TanoRoboRCJ/Hardware/README.md

# Hardware

アートボード 1

ロボットのハードウェアについてのリポジトリです。主に基板を扱います。
