TanoRoboRCJ/Hardware/PCB/01-main/main-re.dxf

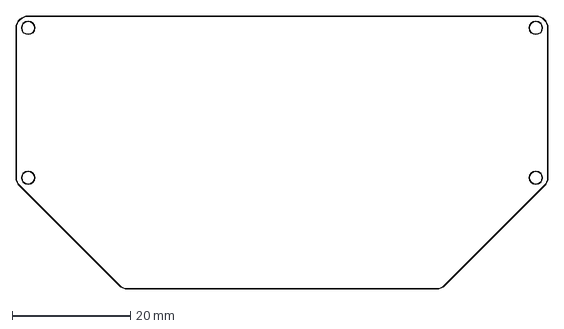
[picture p1: CAD file, 2024-01-18]
PCB/01-main/main-re.dxf
90.0 x 46.2 mm
