TanoRoboRCJ/Hardware/PCB/02-PWR/pwr-re.dxf

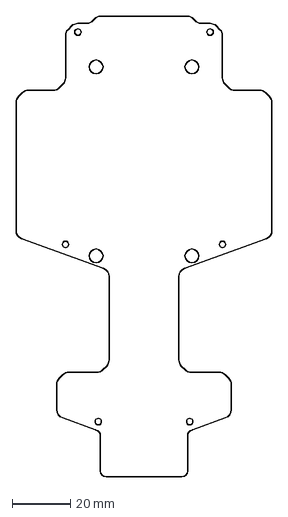
[picture p2: CAD file, 2024-01-20]
PCB/02-PWR/pwr-re.dxf
88.0 x 158.5 mm
