TanoRoboRCJ/Hardware/PCB/01-main.pdf

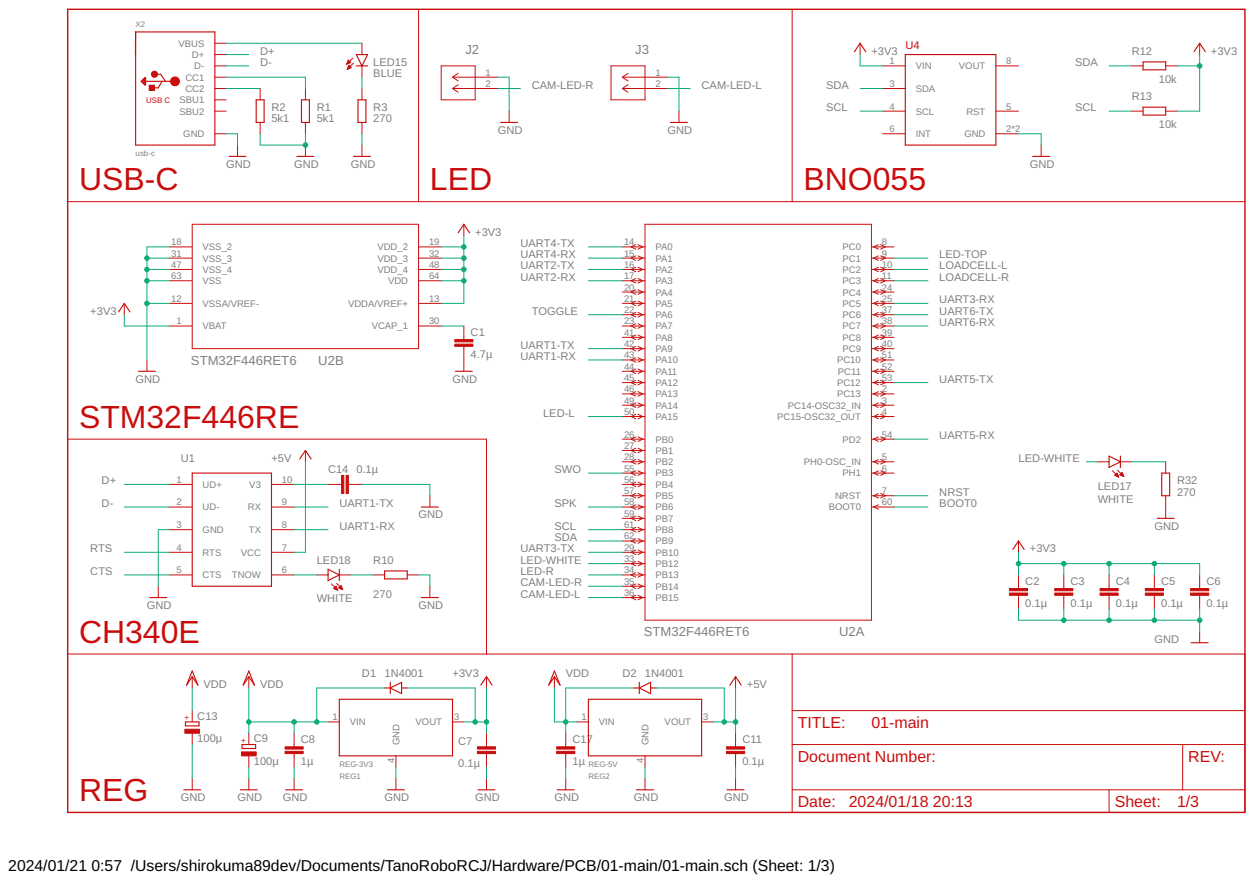
[picture p3: page 1]

2024/01/21 0:57 /Users/shirokuma89dev/Documents/TanoRoboRCJ/Hardware/PCB/01-main/01-main.sch (Sheet: 1/3)

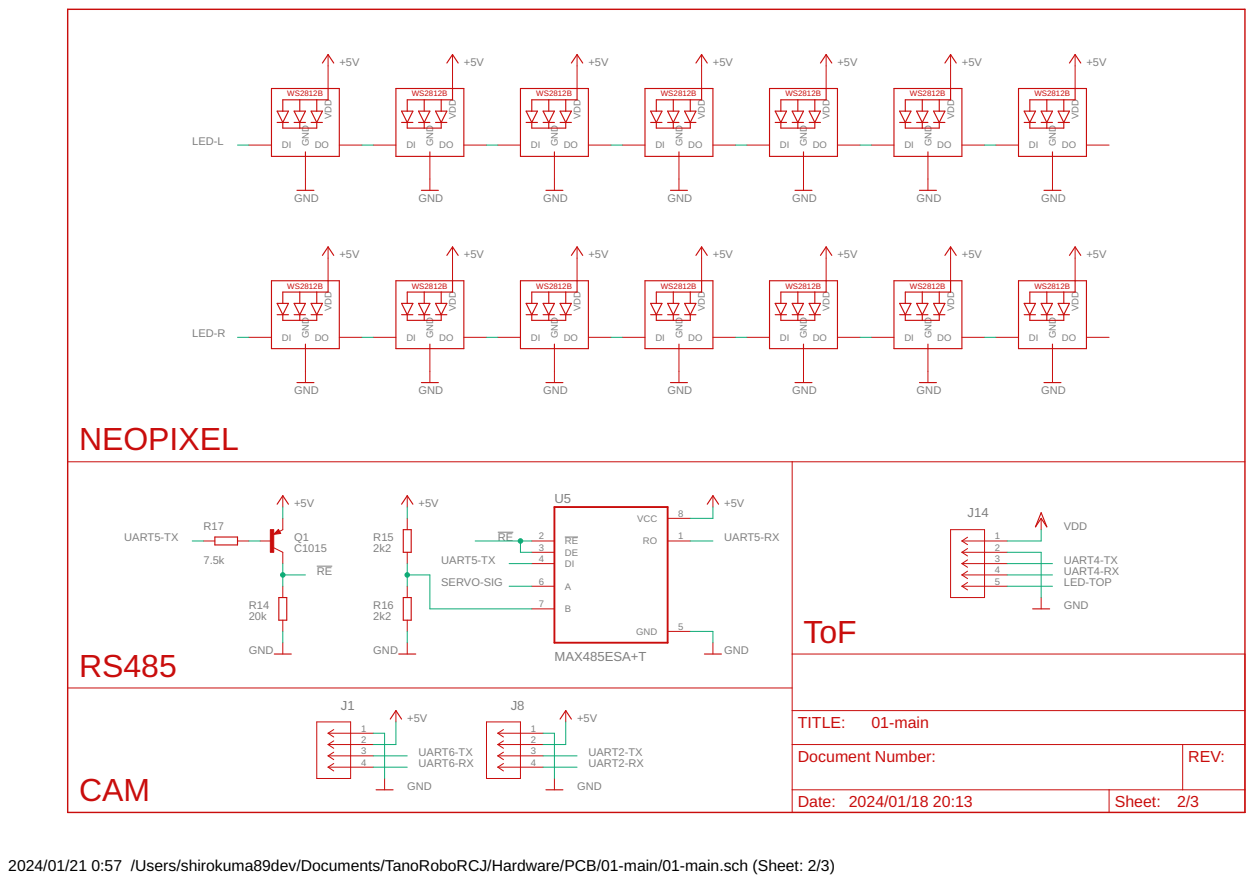
[picture p4: page 2]

2024/01/21 0:57 /Users/shirokuma89dev/Documents/TanoRoboRCJ/Hardware/PCB/01-main/01-main.sch (Sheet: 2/3)

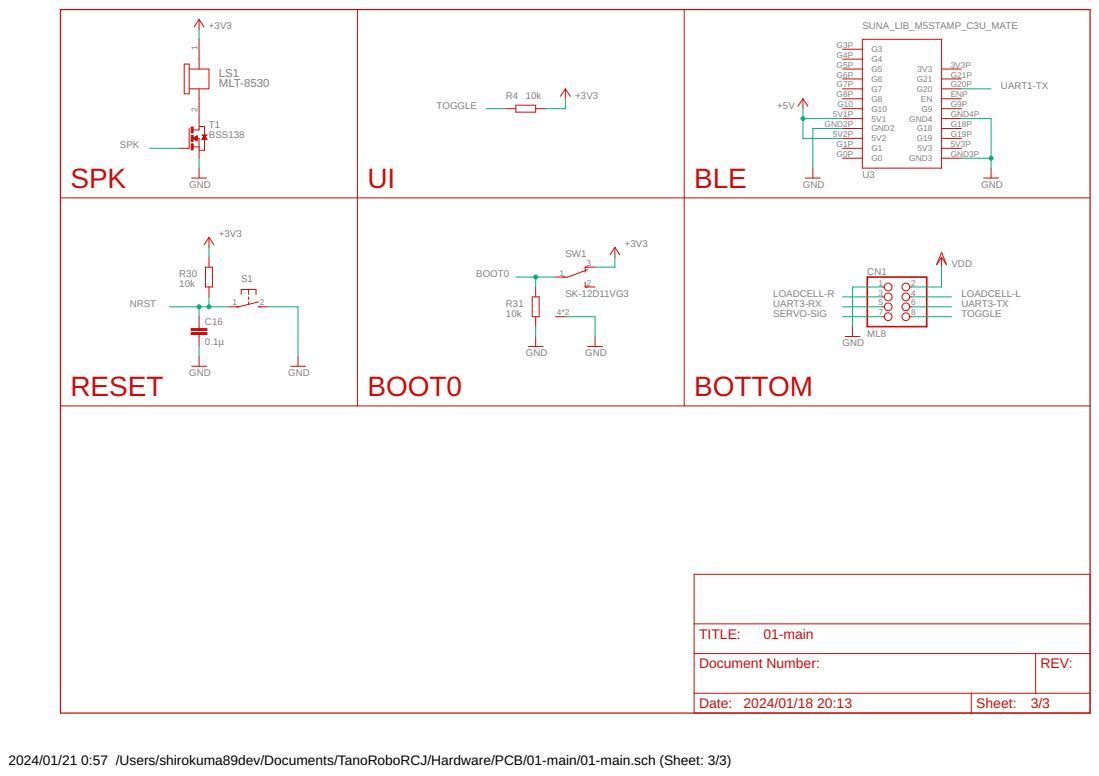
[picture p5: page 3]

Document Number: | REV:

Date: 2024/01/18 20:13 | Sheet: 3/3

2024/01/21 0:57 /Users/shirokuma89dev/Documents/TanoRoboRCJ/Hardware/PCB/01-main/01-main.sch (Sheet: 3/3)
