TanoRoboRCJ/Hardware/PCB/02-PWR/02-PWR.brd

## EAGLE design PCB/02-PWR/02-PWR.brd (2024-01-26)

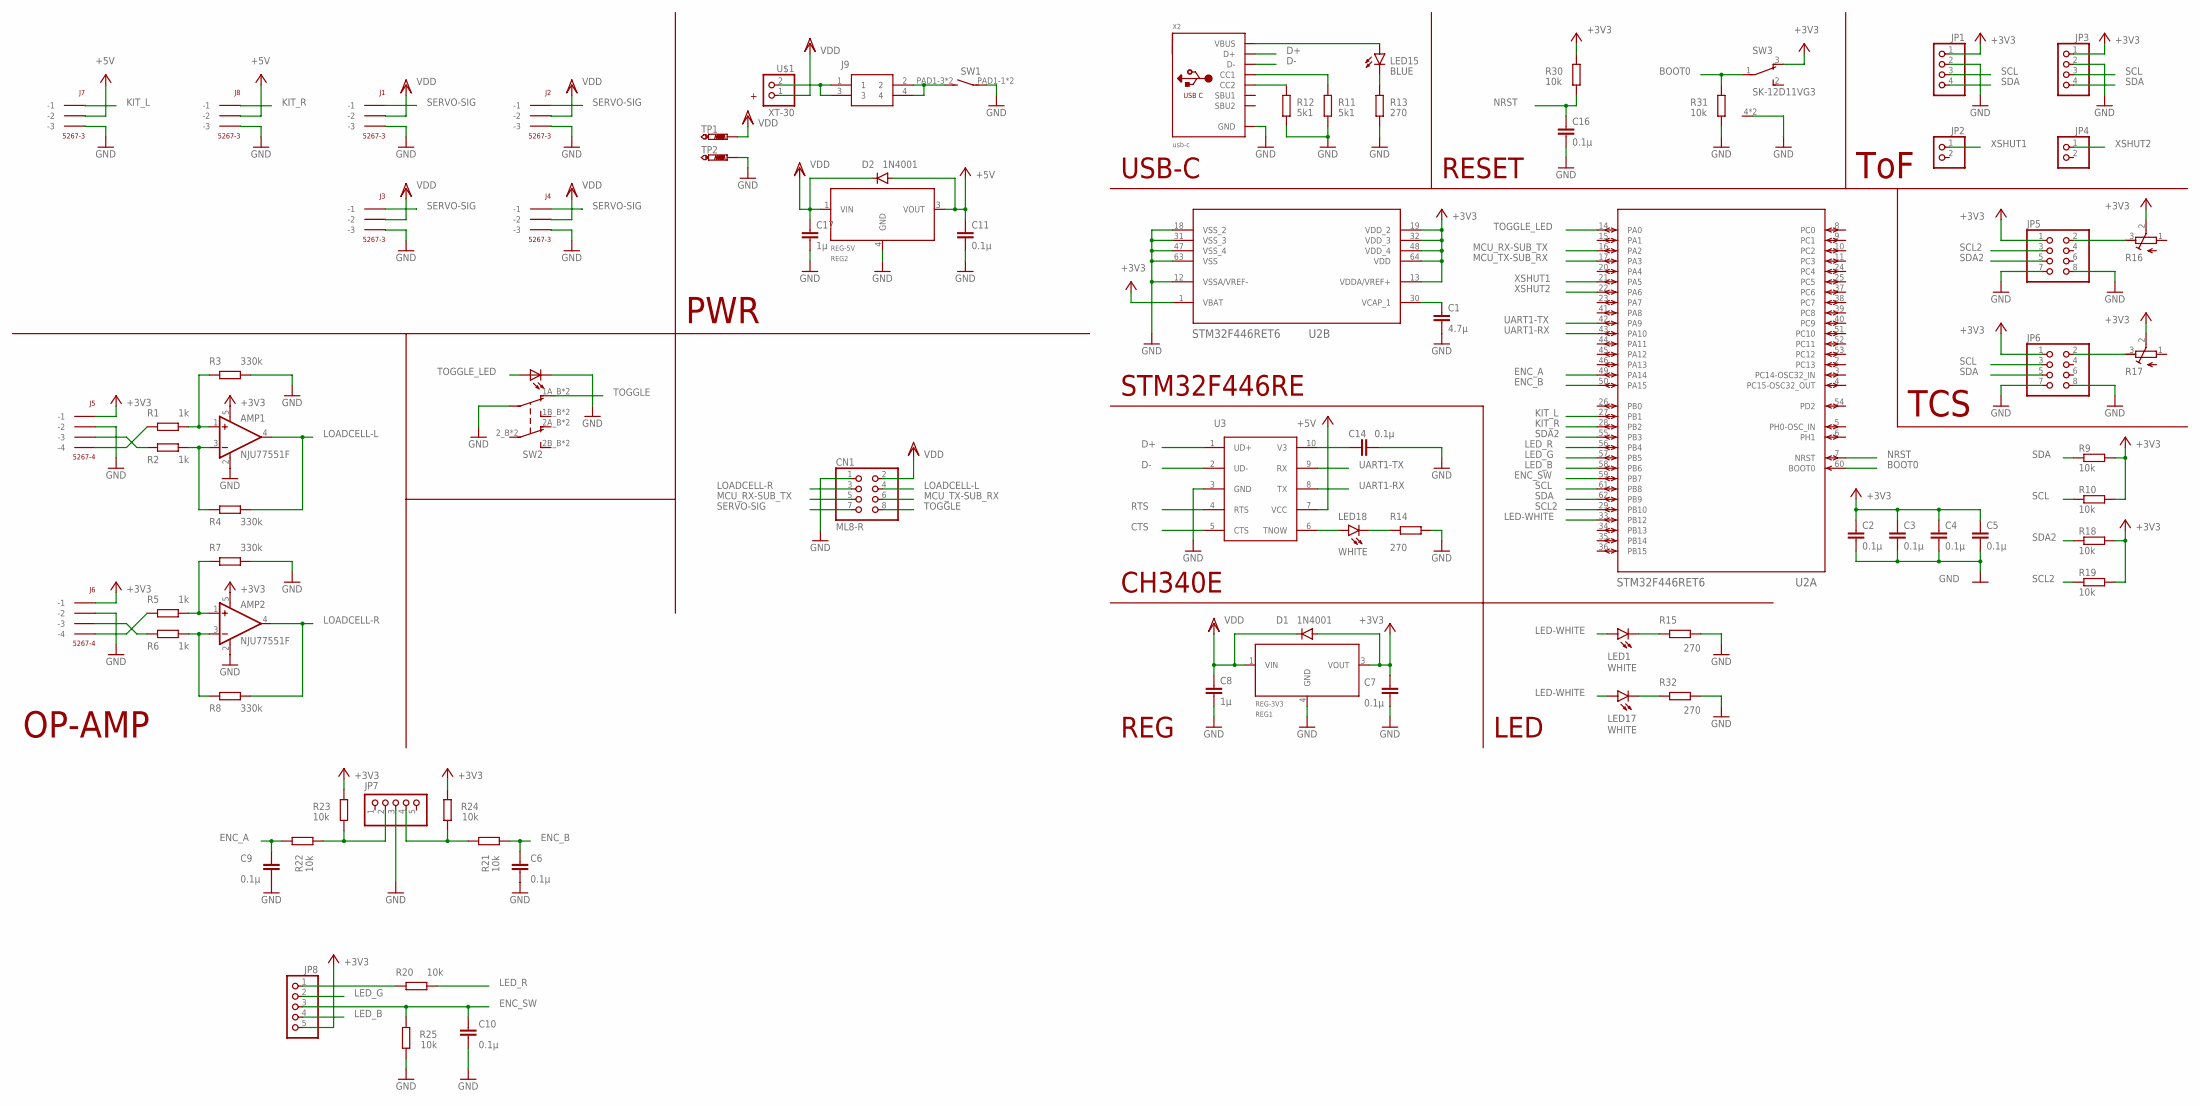
[picture p6: schematic 02-PWR.sch]

Parts:
AMP1, AMP2: NJU77551F; SOT23-5
C1: 4.7µ; C0603
C2, C3, C4, C5, C6, C7, C9, C10, C11, C14, C16: 0.1µ; C0603
C8, C17: 1µ; C0603
CN1: ML8-R; ML6
D1, D2: 1N4001; SMA-DO214AC
J1, J2, J3, J4, J7, J8: 5267-3
J5, J6: 5267-4
J9: 3557-2
JP1, JP3: PINHD-1X4; 1X04
JP2, JP4: PINHD-1X2; 1X02
JP5, JP6: PINHD-2X4; 2X04
JP7, JP8: PINHD-1X5; 1X05
LED1, LED17, LED18: WHITE; SML0603
LED15: BLUE; SML0603
R1, R2, R5, R6: 1k; R0805
R3, R4, R7, R8: 330k; R0805
R9, R10, R18, R19, R20, R21, R22, R23, R24, R25, R30, R31: 10k; R0402
R11, R12: 5k1; R0402
R13, R14, R15, R32: 270; R0402
R16, R17: R-TRIMM3339P; RTRIM3339P
REG1: REG-3V3; MYPARTS_D-PAK_TO252AA
REG2: REG-5V; MYPARTS_D-PAK_TO252AA
SW1: MYPARTS2_C01B02BKBK-EI
SW2: TL22
SW3: SK-12D11VG3
TP1, TP2: PTR1TP16R; TP16R
U2: STM32F446RET6; LQFP64-10X10MM
U3: CH340ESMD; MSOP10
U$1: XT-30
X2: usb-c; USB_C_CUSB31-CFM2AX-01-X

Connections:
+3V3: AMP1.5 (V+), AMP2.5 (V+), C2.1, C3.1, C4.1, C5.1, C7.1, D1.A, J5.P$1 (-1), J6.P$1 (-1), JP1.1, JP3.1, JP5.1, JP6.1, JP8.5, R9.2, R10.2, R16.2 (S), R17.2 (S), R18.2, R19.2, R23.1, R24.1, R30.1, REG1.3 (VOUT), SW3.3 (O), U2.1 (VBAT), U2.13 (VDDA/VREF+), U2.19 (VDD_2), U2.32 (VDD_3), U2.48 (VDD_4), U2.64 (VDD)
+5V: C11.1, D2.A, J7.P$2 (-2), J8.P$2 (-2), REG2.3 (VOUT), U3.7 (VCC)
BOOT0: R31.1, SW3.1, U2.60 (BOOT0)
CTS: U3.5 (CTS)
D+: U3.1 (UD+), X2.A6 (D+), X2.B6 (D+)
D-: U3.2 (UD-), X2.A7 (D-), X2.B7 (D-)
ENC_A: C9.1, R22.1, U2.49 (PA14)
ENC_B: C6.1, R21.2, U2.50 (PA15)
ENC_SW: C10.1, JP8.3, R25.1, U2.59 (PB7)
GND: AMP1.2 (V-), AMP2.2 (V-), C1.2, C2.2, C3.2, C4.2, C5.2, C6.2, C7.2, C8.2, C9.2, C10.2, C11.2, C14.2, C16.2, C17.2, CN1.1, J1.P$3 (-3), J2.P$3 (-3), J3.P$3 (-3), J4.P$3 (-3), J5.P$2 (-2), J6.P$2 (-2), J7.P$3 (-3), J8.P$3 (-3), JP1.2, JP3.2, JP5.7, JP5.8, JP6.7, JP6.8, JP7.3, R3.2, R7.2, R11.2, R12.2, R13.1, R14.1, R15.1, R25.2, R31.2, R32.1, REG1.4 (GND), REG2.4 (GND), SW1.PAD1-1, SW1.PAD1-2, SW2.1_B (1), SW2.1_T (1), SW2.L-_B (C), SW2.L-_T (C), SW3.4 (CASE), SW3.5 (CASE), TP2.TP, U2.12 (VSSA/VREF-), U2.18 (VSS_2), U2.31 (VSS_3), U2.47 (VSS_4), U2.63 (VSS), U3.3 (GND), X2.A1B12 (GND), X2.B1A12 (GND)
KIT_L: J7.P$1 (-1), U2.27 (PB1)
KIT_R: J8.P$1 (-1), U2.28 (PB2)
LED-WHITE: LED1.A, LED17.A, U2.33 (PB12)
LED_B: JP8.4, U2.58 (PB6)
LED_G: JP8.2, U2.57 (PB5)
LED_R: R20.2, U2.56 (PB4)
LOADCELL-L: AMP1.4 (OUT), CN1.4, R4.2
LOADCELL-R: AMP2.4 (OUT), CN1.3, R8.2
MCU_RX-SUB_TX: CN1.5, U2.16 (PA2)
MCU_TX-SUB_RX: CN1.6, U2.17 (PA3)
unnamed: J5.P$3 (-3), R2.1
unnamed: J5.P$4 (-4), R1.1
unnamed: AMP1.3 (-IN), R2.2, R4.1
unnamed: AMP1.1 (+IN), R1.2, R3.1
unnamed: J6.P$3 (-3), R6.1
unnamed: J6.P$4 (-4), R5.1
unnamed: AMP2.3 (-IN), R6.2, R8.1
unnamed: AMP2.1 (+IN), R5.2, R7.1
unnamed: J9.1, J9.3, U$1.2
unnamed: J9.2, J9.4, SW1.PAD1-3 (S), SW1.PAD1-4 (S)
unnamed: C14.1, U3.10 (V3)
unnamed: LED1.C, R15.2
unnamed: JP5.2, R16.3 (E)
unnamed: R11.1, X2.A5 (CC1)
unnamed: R12.1, X2.B5 (CC2)
unnamed: LED15.C, R13.2
unnamed: JP6.2, R17.3 (E)
unnamed: C1.1, U2.30 (VCAP_1)
unnamed: LED18.A, U3.6 (TNOW)
unnamed: LED18.C, R14.2
unnamed: JP7.4, R21.1, R24.2
unnamed: JP7.2, R22.2, R23.2
unnamed: JP8.1, R20.1
unnamed: LED17.C, R32.2
unnamed: LED15.A, X2.A4B9 (VBUS), X2.B4A9 (VBUS)
NRST: C16.1, R30.2, U2.7 (NRST)
RTS: U3.4 (RTS)
SCL: JP1.3, JP3.3, JP6.3, R10.1, U2.61 (PB8)
SCL2: JP5.3, R19.1, U2.29 (PB10)
SDA: JP1.4, JP3.4, JP6.5, R9.1, U2.62 (PB9)
SDA2: JP5.5, R18.1, U2.55 (PB3)
SERVO-SIG: CN1.7, J1.P$1 (-1), J2.P$1 (-1), J3.P$1 (-1), J4.P$1 (-1)
TOGGLE: CN1.8, SW2.1A_B (1A), SW2.1A_T (1A)
TOGGLE_LED: SW2.L+_B (A), SW2.L+_T (A), U2.14 (PA0)
UART1-RX: U2.43 (PA10), U3.8 (TX)
UART1-TX: U2.42 (PA9), U3.9 (RX)
VDD: C8.1, C17.1, CN1.2, D1.K (C), D2.K (C), J1.P$2 (-2), J2.P$2 (-2), J3.P$2 (-2), J4.P$2 (-2), REG1.1 (VIN), REG2.1 (VIN), TP1.TP, U$1.1
XSHUT1: JP2.1, U2.21 (PA5)
XSHUT2: JP4.1, U2.22 (PA6)

Notes on the sheet:
PWR
ToF
OP-AMP
STM32F446RE
REG
CH340E
USB-C
RESET
LED
TCS

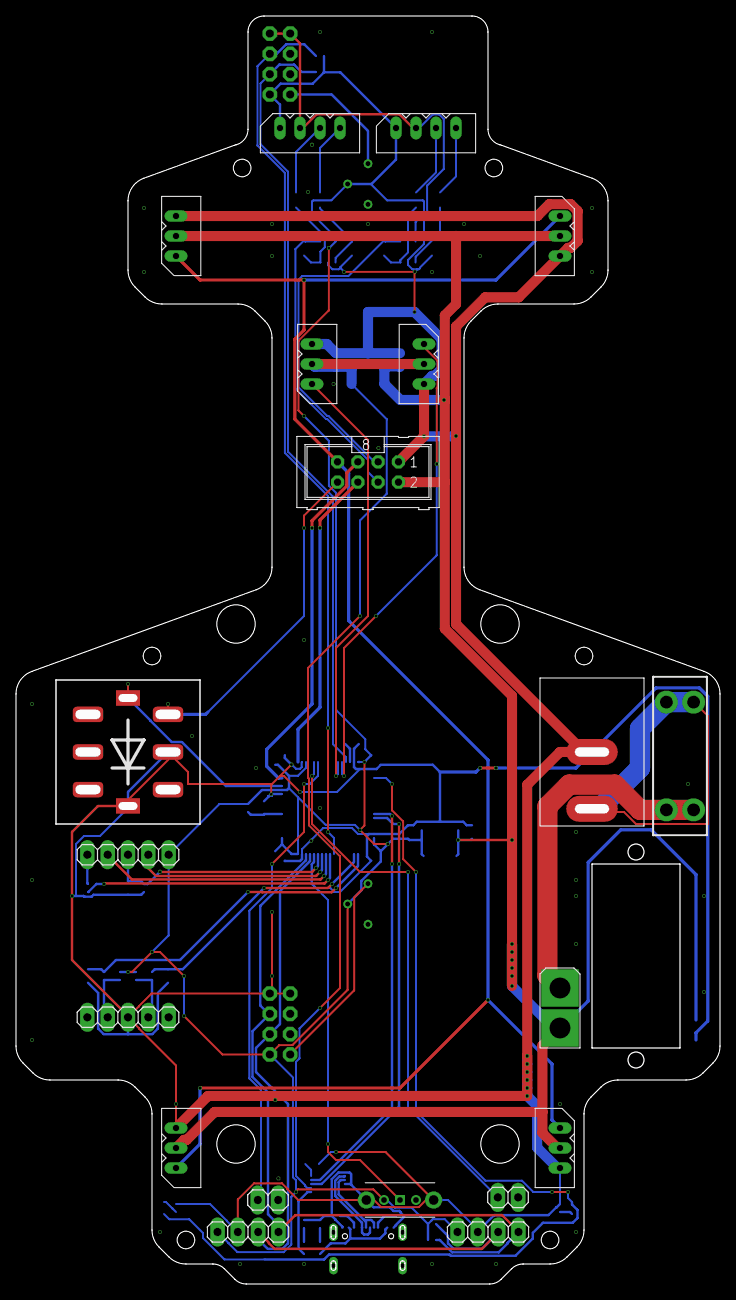
[picture p7: board 02-PWR.brd from above]

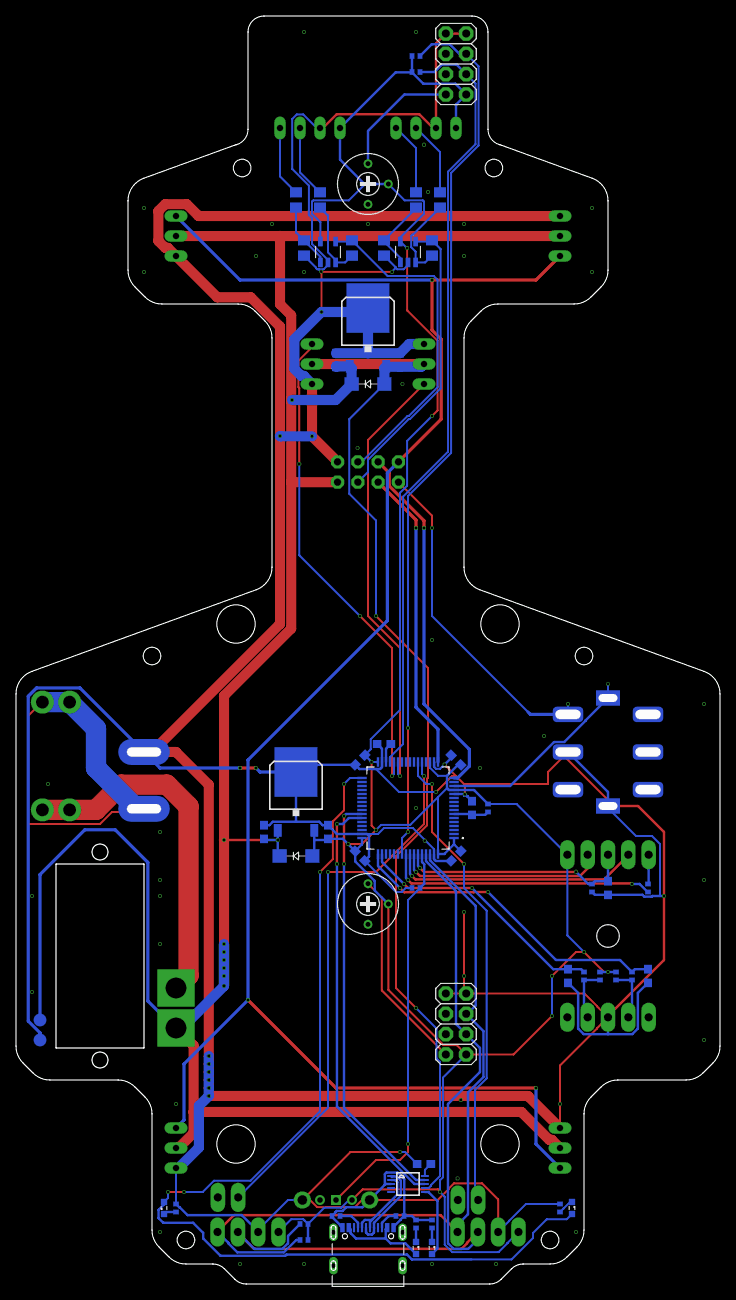
[picture p8: board 02-PWR.brd from below]

Board: 2 copper layers, 88.0 x 158.5 mm, 79 parts (59 on the bottom side), 57 nets.
