TanoRoboRCJ/Hardware/PCB/03-LiDAR/03-LiDAR.brd

## EAGLE design PCB/03-LiDAR/03-LiDAR.brd (2024-01-25)

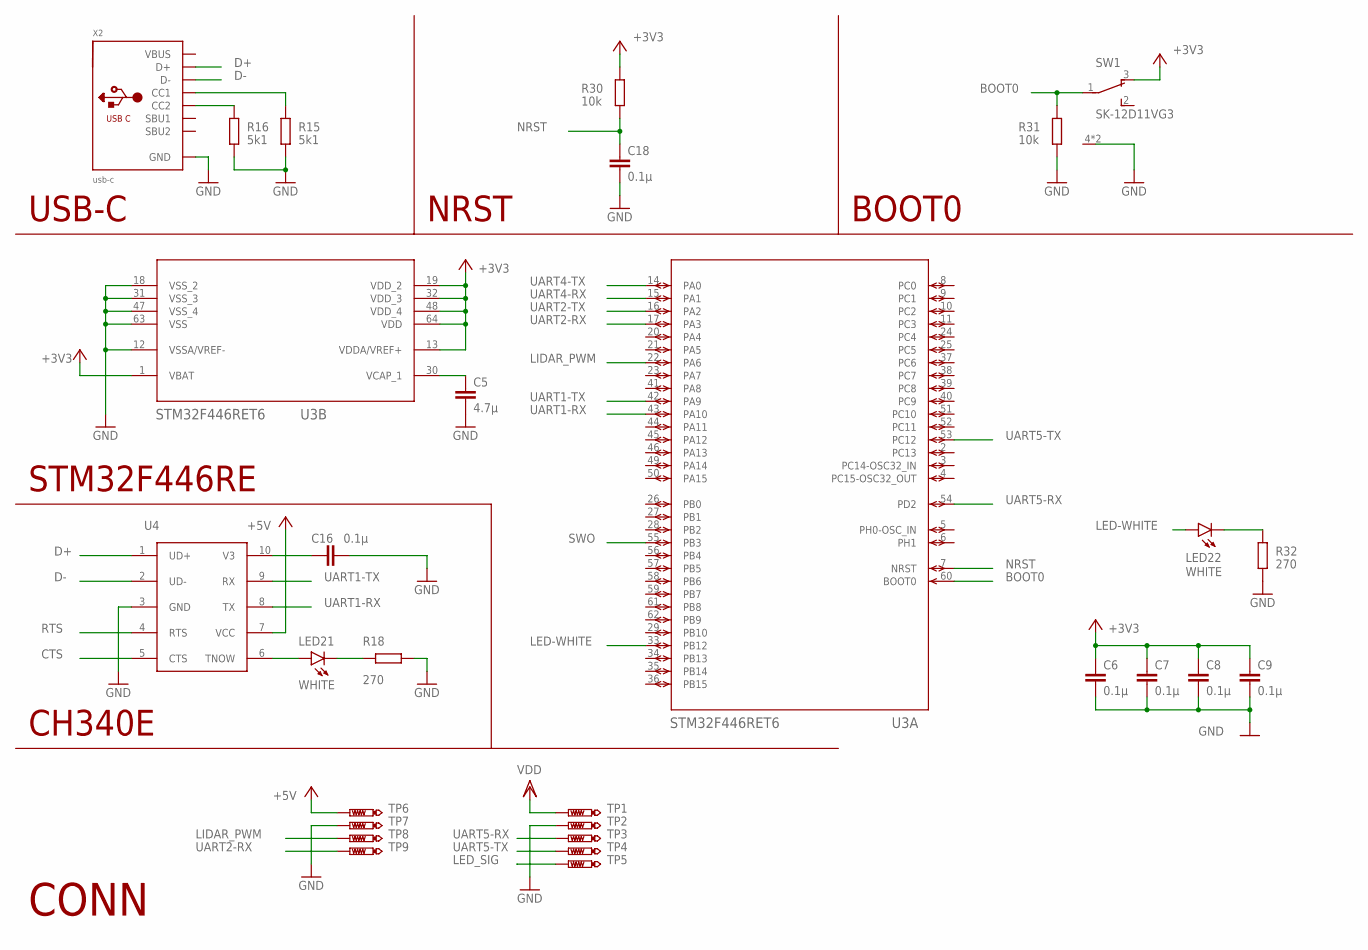
[picture p9: schematic 03-LiDAR.sch, sheet 1]

Parts:
C5: 4.7µ; C0603
C6, C7, C8, C9, C16, C18: 0.1µ; C0603
LED21, LED22: WHITE; SML0603
R15, R16: 5k1; R0402
R18, R32: 270; R0402
R30, R31: 10k; R0402
SW1: SK-12D11VG3
TP1, TP3, TP4, TP5, TP6, TP8, TP9: PTR1TP10R; TP10R
TP2, TP7: PTR1TP10SQ; TP10SQ
U3: STM32F446RET6; LQFP64-10X10MM
U4: CH340ESMD; MSOP10
X2: usb-c; USB_C_CUSB31-CFM2AX-01-X

Connections:
+3V3: C6.1, C7.1, C8.1, C9.1, R30.1, SW1.3 (O), U3.1 (VBAT), U3.13 (VDDA/VREF+), U3.19 (VDD_2), U3.32 (VDD_3), U3.48 (VDD_4), U3.64 (VDD); also elsewhere on the board
+5V: TP6.TP, U4.7 (VCC); also elsewhere on the board
BOOT0: R31.1, SW1.1, U3.60 (BOOT0)
CTS: U4.5 (CTS)
D+: U4.1 (UD+), X2.A6 (D+), X2.B6 (D+)
D-: U4.2 (UD-), X2.A7 (D-), X2.B7 (D-)
GND: C5.2, C6.2, C7.2, C8.2, C9.2, C16.2, C18.2, R15.2, R16.2, R18.1, R31.2, R32.1, SW1.4 (CASE), SW1.5 (CASE), TP2.TP, TP7.TP, U3.12 (VSSA/VREF-), U3.18 (VSS_2), U3.31 (VSS_3), U3.47 (VSS_4), U3.63 (VSS), U4.3 (GND), X2.A1B12 (GND), X2.B1A12 (GND); also elsewhere on the board
LED-WHITE: LED22.A, U3.33 (PB12)
LED_SIG: TP5.TP; also elsewhere on the board
LIDAR_PWM: TP8.TP, U3.22 (PA6)
unnamed: R15.1, X2.A5 (CC1)
unnamed: R16.1, X2.B5 (CC2)
unnamed: C5.1, U3.30 (VCAP_1)
unnamed: C16.1, U4.10 (V3)
unnamed: LED21.A, U4.6 (TNOW)
unnamed: LED21.C, R18.2
unnamed: LED22.C, R32.2
NRST: C18.1, R30.2, U3.7 (NRST)
RTS: U4.4 (RTS)
SWO: U3.55 (PB3)
UART1-RX: U3.43 (PA10), U4.8 (TX)
UART1-TX: U3.42 (PA9), U4.9 (RX)
UART2-RX: TP9.TP, U3.17 (PA3)
UART2-TX: U3.16 (PA2)
UART4-RX: U3.15 (PA1); also elsewhere on the board
UART4-TX: U3.14 (PA0)
UART5-RX: TP3.TP, U3.54 (PD2); also elsewhere on the board
UART5-TX: TP4.TP, U3.53 (PC12)
VBUS: X2.A4B9 (VBUS), X2.B4A9 (VBUS)
VDD: TP1.TP; also elsewhere on the board

Notes on the sheet:
CONN
STM32F446RE
CH340E
USB-C
BOOT0
NRST

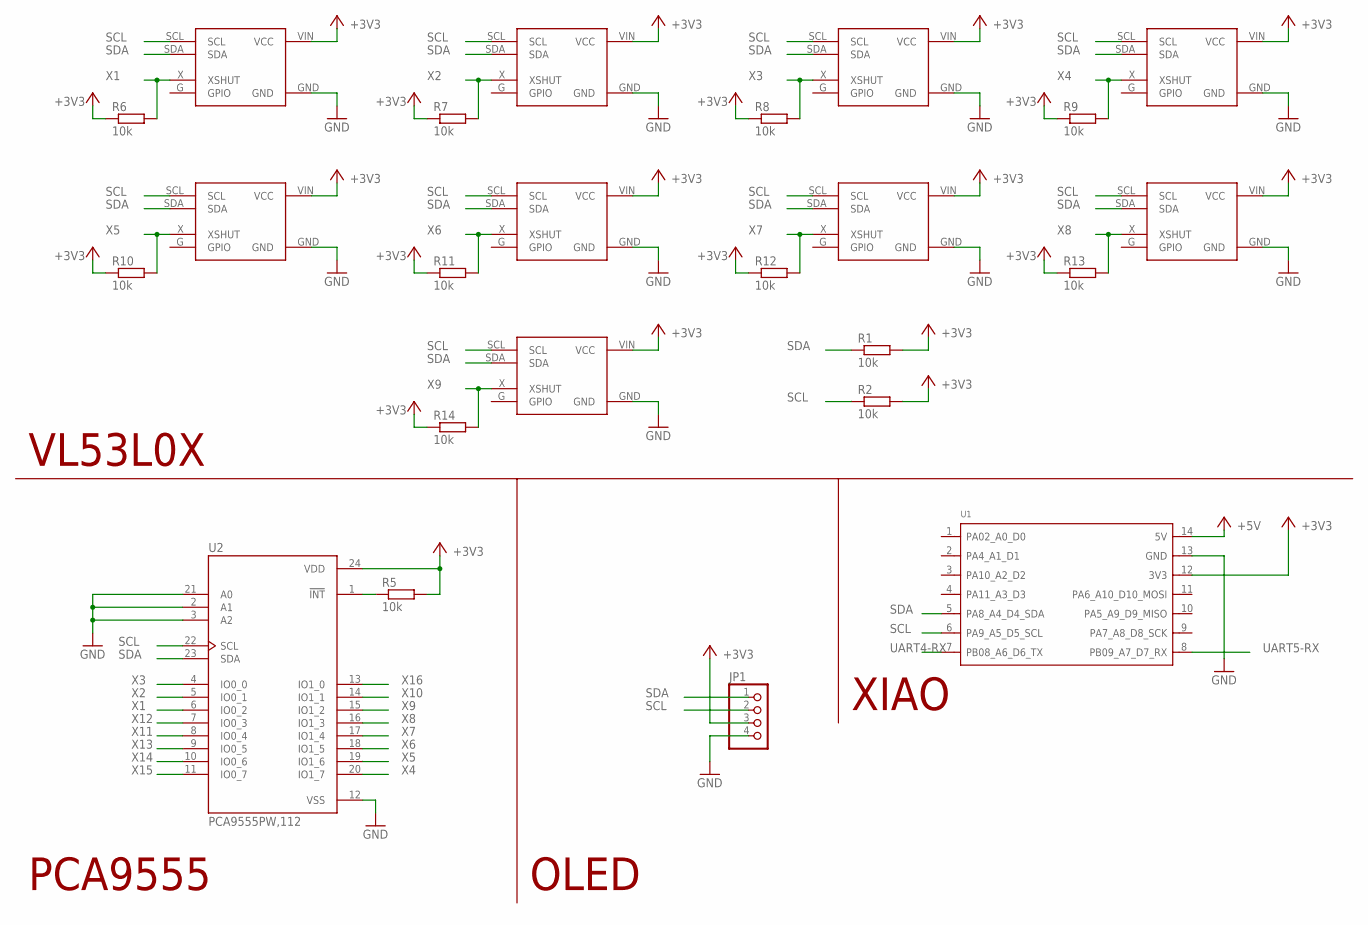
[picture p10: schematic 03-LiDAR.sch, sheet 2]

Parts:
JP1: PINHD-1X4; 1X04
R1, R2, R5, R6, R7, R8, R9, R10, R11, R12, R13, R14: 10k; R0402
U1: MOUDLE-SEEEDUINO-XIAO; MOUDLE14P-2.54-21X17.8MM
U2: PCA9555PW,112; SOP65P640X110-24N
VL1, VL2, VL3, VL4, VL5, VL6, VL7, VL8, VL9: VL53L0X; 1X04

Connections:
+3V3: JP1.3, R1.2, R2.2, R5.2, R6.1, R7.1, R8.1, R9.1, R10.1, R11.1, R12.1, R13.1, R14.1, U1.12 (3V3), U2.24 (VDD), VL1.VIN (VCC), VL2.VIN (VCC), VL3.VIN (VCC), VL4.VIN (VCC), VL5.VIN (VCC), VL6.VIN (VCC), VL7.VIN (VCC), VL8.VIN (VCC), VL9.VIN (VCC); also elsewhere on the board
+5V: U1.14 (5V); also elsewhere on the board
GND: JP1.4, U1.13 (GND), U2.2 (A1), U2.3 (A2), U2.12 (VSS), U2.21 (A0), VL1.GND, VL2.GND, VL3.GND, VL4.GND, VL5.GND, VL6.GND, VL7.GND, VL8.GND, VL9.GND; also elsewhere on the board
unnamed: R5.1, U2.1 (!INT)
SCL: JP1.2, R2.1, U1.6 (PA9_A5_D5_SCL), U2.22 (SCL), VL1.SCL, VL2.SCL, VL3.SCL, VL4.SCL, VL5.SCL, VL6.SCL, VL7.SCL, VL8.SCL, VL9.SCL
SDA: JP1.1, R1.1, U1.5 (PA8_A4_D4_SDA), U2.23 (SDA), VL1.SDA, VL2.SDA, VL3.SDA, VL4.SDA, VL5.SDA, VL6.SDA, VL7.SDA, VL8.SDA, VL9.SDA
UART4-RX: U1.7 (PB08_A6_D6_TX); also elsewhere on the board
UART5-RX: U1.8 (PB09_A7_D7_RX); also elsewhere on the board
X1: R6.2, U2.6 (IO0_2), VL1.X (XSHUT)
X2: R7.2, U2.5 (IO0_1), VL2.X (XSHUT)
X3: R8.2, U2.4 (IO0_0), VL3.X (XSHUT)
X4: R9.2, U2.20 (IO1_7), VL4.X (XSHUT)
X5: R10.2, U2.19 (IO1_6), VL5.X (XSHUT)
X6: R11.2, U2.18 (IO1_5), VL6.X (XSHUT)
X7: R12.2, U2.17 (IO1_4), VL7.X (XSHUT)
X8: R13.2, U2.16 (IO1_3), VL8.X (XSHUT)
X9: R14.2, U2.15 (IO1_2), VL9.X (XSHUT)
X10: U2.14 (IO1_1)
X11: U2.8 (IO0_4)
X12: U2.7 (IO0_3)
X13: U2.9 (IO0_5)
X14: U2.10 (IO0_6)
X15: U2.11 (IO0_7)
X16: U2.13 (IO1_0)

Notes on the sheet:
VL53L0X
XIAO
PCA9555
OLED

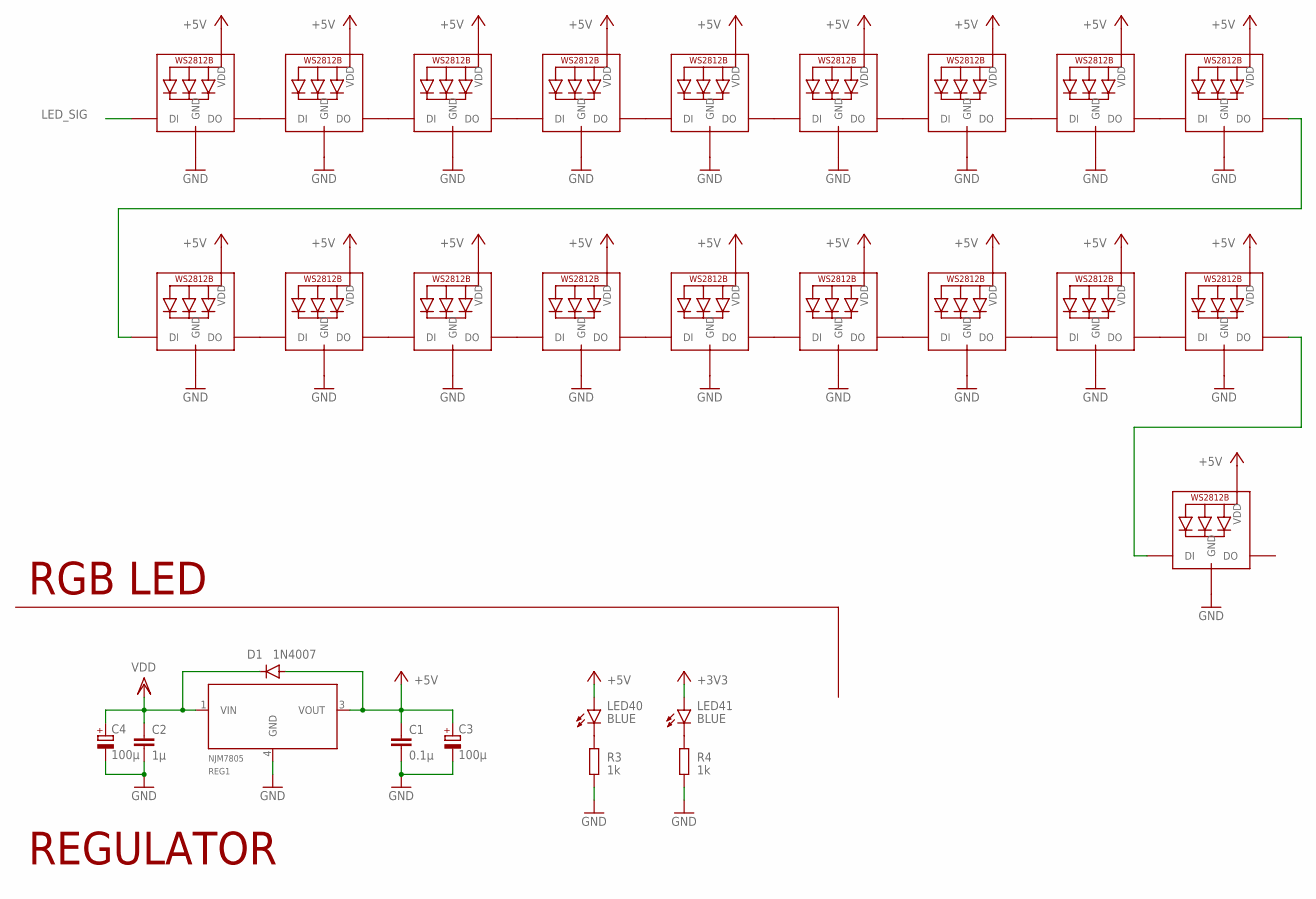
[picture p11: schematic 03-LiDAR.sch, sheet 3]

Parts:
C1: 0.1μ; C0402
C2: 1μ; C0402
C3, C4: 100μ; 153CLV-0505
D1: 1N4007; SMA-DO214AC
LED1, LED2, LED3, LED4, LED5, LED6, LED7, LED8, LED9, LED10, LED11, LED12, LED13, LED14, LED15, LED16, LED17, LED18, LED19: WS2812B_5050N; WS2812B-NARROW
LED40, LED41: BLUE; SML0603
R3, R4: 1k; R0402
REG1: NJM7805; MYPARTS_D-PAK_TO252AA

Connections:
+3V3: LED41.A; also elsewhere on the board
+5V: C1.1, C3.+, D1.A, LED1.1-VDD (VDD), LED2.1-VDD (VDD), LED3.1-VDD (VDD), LED4.1-VDD (VDD), LED5.1-VDD (VDD), LED6.1-VDD (VDD), LED7.1-VDD (VDD), LED8.1-VDD (VDD), LED9.1-VDD (VDD), LED10.1-VDD (VDD), LED11.1-VDD (VDD), LED12.1-VDD (VDD), LED13.1-VDD (VDD), LED14.1-VDD (VDD), LED15.1-VDD (VDD), LED16.1-VDD (VDD), LED17.1-VDD (VDD), LED18.1-VDD (VDD), LED19.1-VDD (VDD), LED40.A, REG1.3 (VOUT); also elsewhere on the board
GND: C1.2, C2.2, C3.-, C4.-, LED1.3-GND (GND), LED2.3-GND (GND), LED3.3-GND (GND), LED4.3-GND (GND), LED5.3-GND (GND), LED6.3-GND (GND), LED7.3-GND (GND), LED8.3-GND (GND), LED9.3-GND (GND), LED10.3-GND (GND), LED11.3-GND (GND), LED12.3-GND (GND), LED13.3-GND (GND), LED14.3-GND (GND), LED15.3-GND (GND), LED16.3-GND (GND), LED17.3-GND (GND), LED18.3-GND (GND), LED19.3-GND (GND), R3.2, R4.2, REG1.4 (GND); also elsewhere on the board
LED_SIG: LED1.4-DIN (DI); also elsewhere on the board
unnamed: LED1.2-DOUT (DO), LED2.4-DIN (DI)
unnamed: LED2.2-DOUT (DO), LED3.4-DIN (DI)
unnamed: LED3.2-DOUT (DO), LED4.4-DIN (DI)
unnamed: LED4.2-DOUT (DO), LED5.4-DIN (DI)
unnamed: LED5.2-DOUT (DO), LED6.4-DIN (DI)
unnamed: LED6.2-DOUT (DO), LED7.4-DIN (DI)
unnamed: LED7.2-DOUT (DO), LED8.4-DIN (DI)
unnamed: LED8.2-DOUT (DO), LED9.4-DIN (DI)
unnamed: LED10.2-DOUT (DO), LED11.4-DIN (DI)
unnamed: LED11.2-DOUT (DO), LED12.4-DIN (DI)
unnamed: LED12.2-DOUT (DO), LED13.4-DIN (DI)
unnamed: LED13.2-DOUT (DO), LED14.4-DIN (DI)
unnamed: LED14.2-DOUT (DO), LED15.4-DIN (DI)
unnamed: LED15.2-DOUT (DO), LED16.4-DIN (DI)
unnamed: LED16.2-DOUT (DO), LED17.4-DIN (DI)
unnamed: LED17.2-DOUT (DO), LED18.4-DIN (DI)
unnamed: LED40.C, R3.1
unnamed: LED41.C, R4.1
unnamed: LED9.2-DOUT (DO), LED10.4-DIN (DI)
unnamed: LED18.2-DOUT (DO), LED19.4-DIN (DI)
VDD: C2.1, C4.+, D1.K (C), REG1.1 (VIN); also elsewhere on the board

Notes on the sheet:
REGULATOR
RGB LED

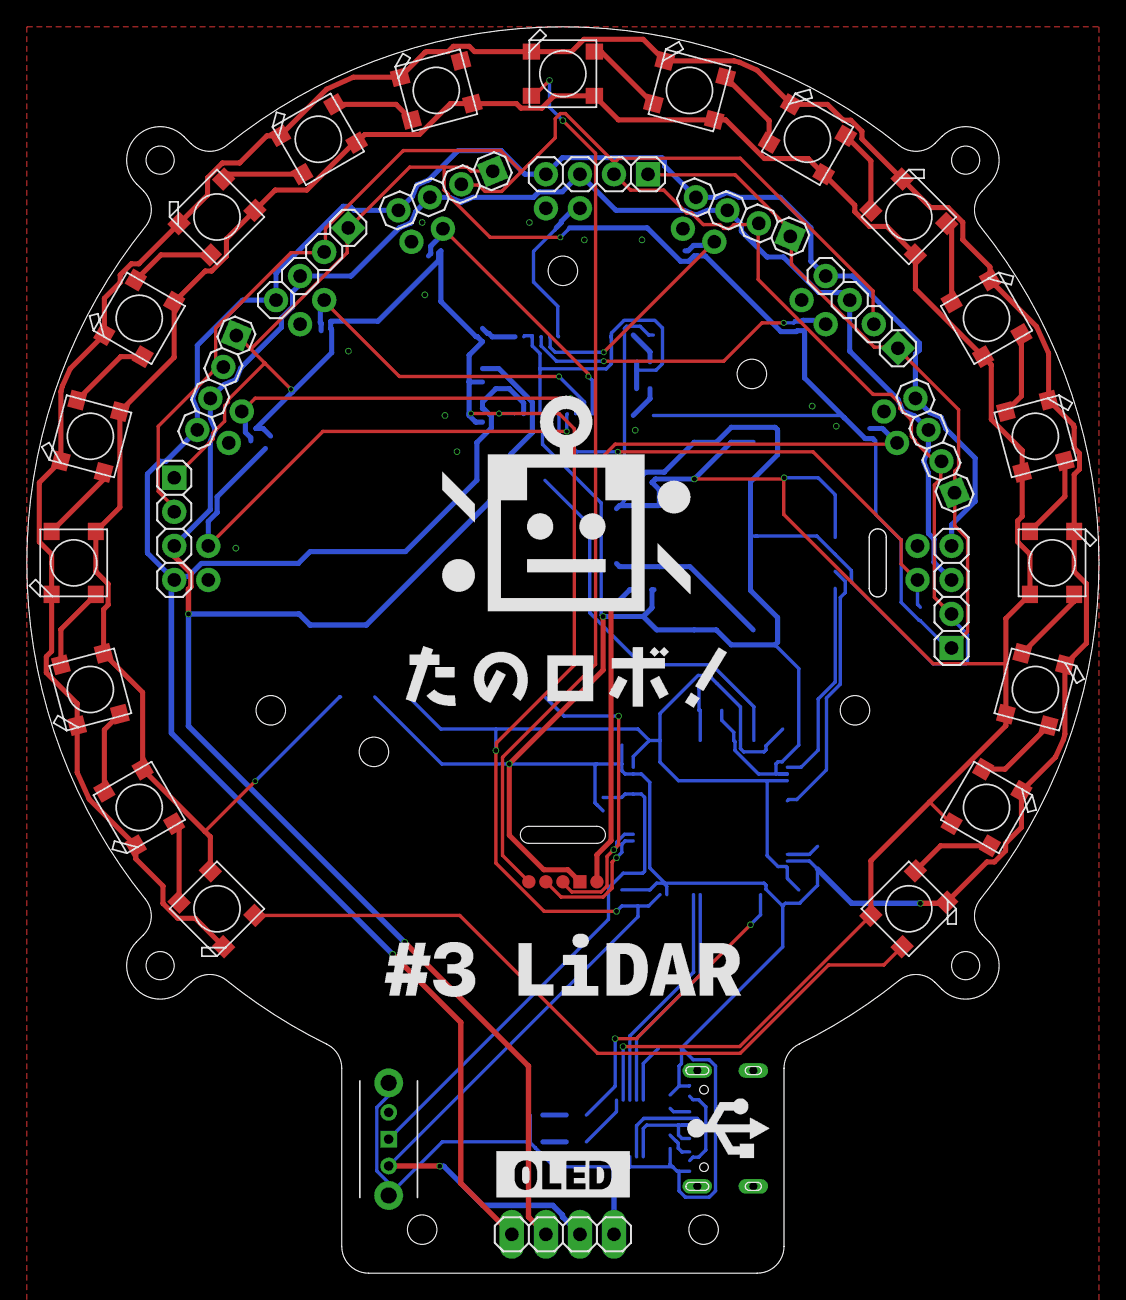
[picture p12: board 03-LiDAR.brd from above]

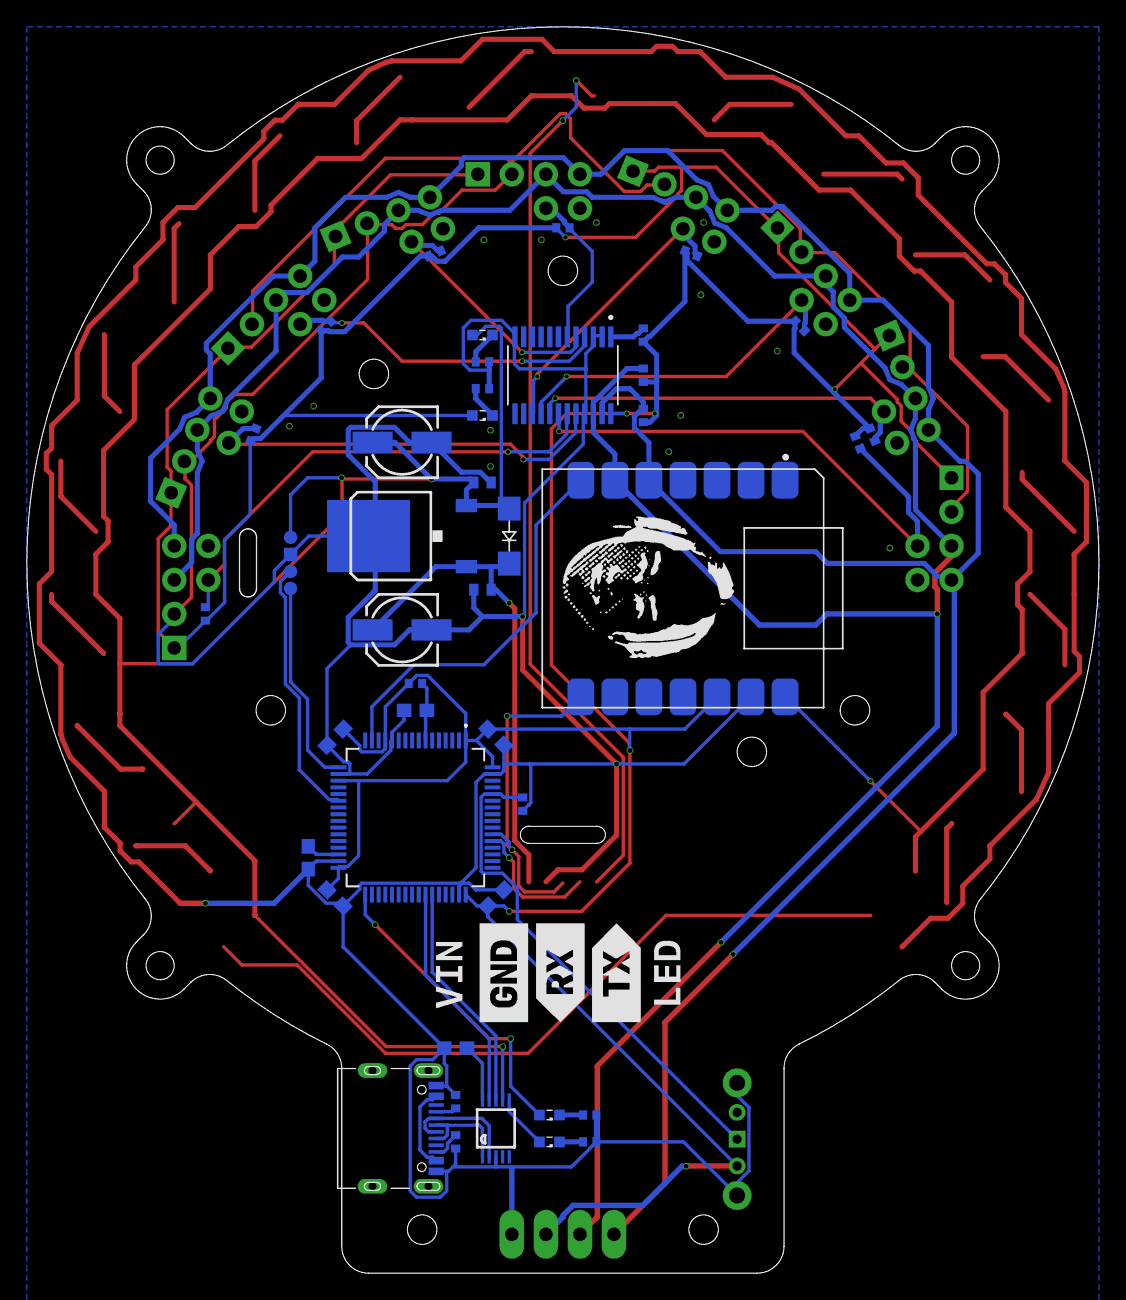
[picture p13: board 03-LiDAR.brd from below]

Board: 2 copper layers, 80.0 x 93.0 mm, 81 parts (46 on the bottom side), 57 nets.
