TanoRoboRCJ/Hardware/PCB/01-main/01-main.brd

## EAGLE design PCB/01-main/01-main.brd (2024-01-22)

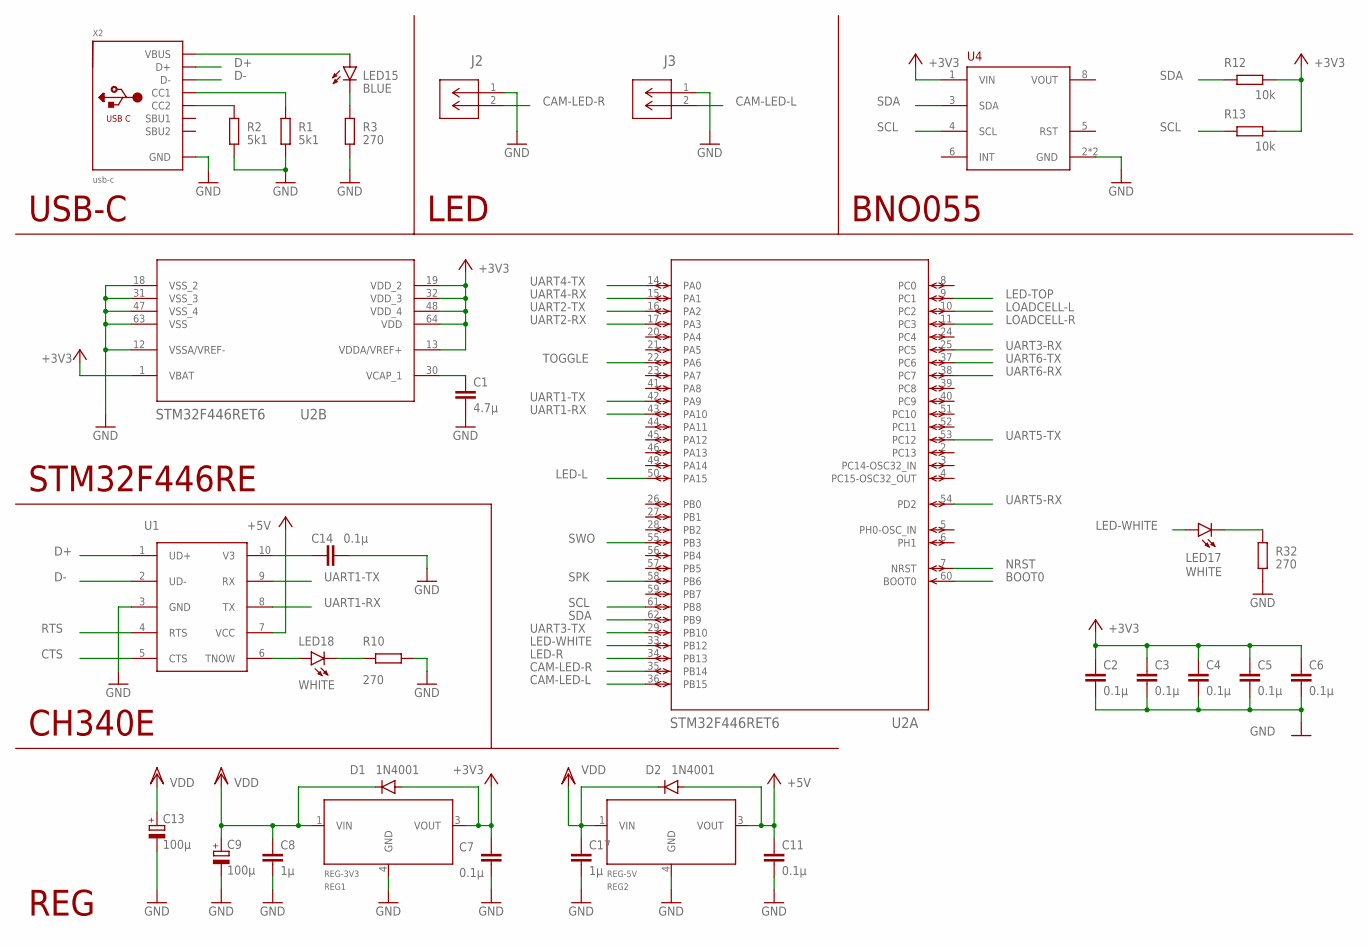
[picture p14: schematic 01-main.sch, sheet 1]

Parts:
C1: 4.7µ; C0603
C2, C3, C4, C5, C6, C7, C11, C14: 0.1µ; C0603
C8, C17: 1µ; C0603
C9, C13: 100μ; 153CLV-0505
D1, D2: 1N4001; SMA-DO214AC
J2, J3: 22057025; CON_22057025_MOL
LED15: BLUE; SML0603
LED17, LED18: WHITE; SML0603
R1, R2: 5k1; R0402
R3, R10, R32: 270; R0402
R12, R13: 10k; R0402
REG1: REG-3V3; MYPARTS_D-PAK_TO252AA
REG2: REG-5V; MYPARTS_D-PAK_TO252AA
U1: CH340ESMD; MSOP10
U2: STM32F446RET6; LQFP64-10X10MM
U4: BNO055; SOCKET-08
X2: usb-c; USB_C_CUSB31-CFM2AX-01-X

Connections:
+3V3: C2.1, C3.1, C4.1, C5.1, C6.1, C7.1, D1.A, R12.1, R13.1, REG1.3 (VOUT), U2.1 (VBAT), U2.13 (VDDA/VREF+), U2.19 (VDD_2), U2.32 (VDD_3), U2.48 (VDD_4), U2.64 (VDD), U4.1 (VIN); also elsewhere on the board
+5V: C11.1, D2.A, REG2.3 (VOUT), U1.7 (VCC); also elsewhere on the board
BOOT0: U2.60 (BOOT0); also elsewhere on the board
CAM-LED-L: J3.2, U2.36 (PB15)
CAM-LED-R: J2.2, U2.35 (PB14)
CTS: U1.5 (CTS)
D+: U1.1 (UD+), X2.A6 (D+), X2.B6 (D+)
D-: U1.2 (UD-), X2.A7 (D-), X2.B7 (D-)
GND: C1.2, C2.2, C3.2, C4.2, C5.2, C6.2, C7.2, C8.2, C9.-, C11.2, C13.-, C14.2, C17.2, J2.1, J3.1, R1.2, R2.2, R3.1, R10.1, R32.1, REG1.4 (GND), REG2.4 (GND), U1.3 (GND), U2.12 (VSSA/VREF-), U2.18 (VSS_2), U2.31 (VSS_3), U2.47 (VSS_4), U2.63 (VSS), U4.2 (GND), U4.7 (GND), X2.A1B12 (GND), X2.B1A12 (GND); also elsewhere on the board
LED-L: U2.50 (PA15); also elsewhere on the board
LED-R: U2.34 (PB13); also elsewhere on the board
LED-TOP: U2.9 (PC1); also elsewhere on the board
LED-WHITE: LED17.A, U2.33 (PB12)
LOADCELL-L: U2.10 (PC2); also elsewhere on the board
LOADCELL-R: U2.11 (PC3); also elsewhere on the board
unnamed: C14.1, U1.10 (V3)
unnamed: R1.1, X2.A5 (CC1)
unnamed: R2.1, X2.B5 (CC2)
unnamed: LED15.C, R3.2
unnamed: C1.1, U2.30 (VCAP_1)
unnamed: LED18.A, U1.6 (TNOW)
unnamed: LED18.C, R10.2
unnamed: LED17.C, R32.2
unnamed: LED15.A, X2.A4B9 (VBUS), X2.B4A9 (VBUS)
NRST: U2.7 (NRST); also elsewhere on the board
RTS: U1.4 (RTS)
SCL: R13.2, U2.61 (PB8), U4.4 (SCL)
SDA: R12.2, U2.62 (PB9), U4.3 (SDA)
SPK: U2.58 (PB6); also elsewhere on the board
SWO: U2.55 (PB3)
TOGGLE: U2.22 (PA6); also elsewhere on the board
UART1-RX: U1.8 (TX), U2.43 (PA10)
UART1-TX: U1.9 (RX), U2.42 (PA9); also elsewhere on the board
UART2-RX: U2.17 (PA3); also elsewhere on the board
UART2-TX: U2.16 (PA2); also elsewhere on the board
UART3-RX: U2.25 (PC5); also elsewhere on the board
UART3-TX: U2.29 (PB10); also elsewhere on the board
UART4-RX: U2.15 (PA1); also elsewhere on the board
UART4-TX: U2.14 (PA0); also elsewhere on the board
UART5-RX: U2.54 (PD2); also elsewhere on the board
UART5-TX: U2.53 (PC12); also elsewhere on the board
UART6-RX: U2.38 (PC7); also elsewhere on the board
UART6-TX: U2.37 (PC6); also elsewhere on the board
VDD: C8.1, C9.+, C13.+, C17.1, D1.K (C), D2.K (C), REG1.1 (VIN), REG2.1 (VIN); also elsewhere on the board
VOUT: U4.8 (VOUT)

Notes on the sheet:
STM32F446RE
REG
CH340E
USB-C
BNO055
LED

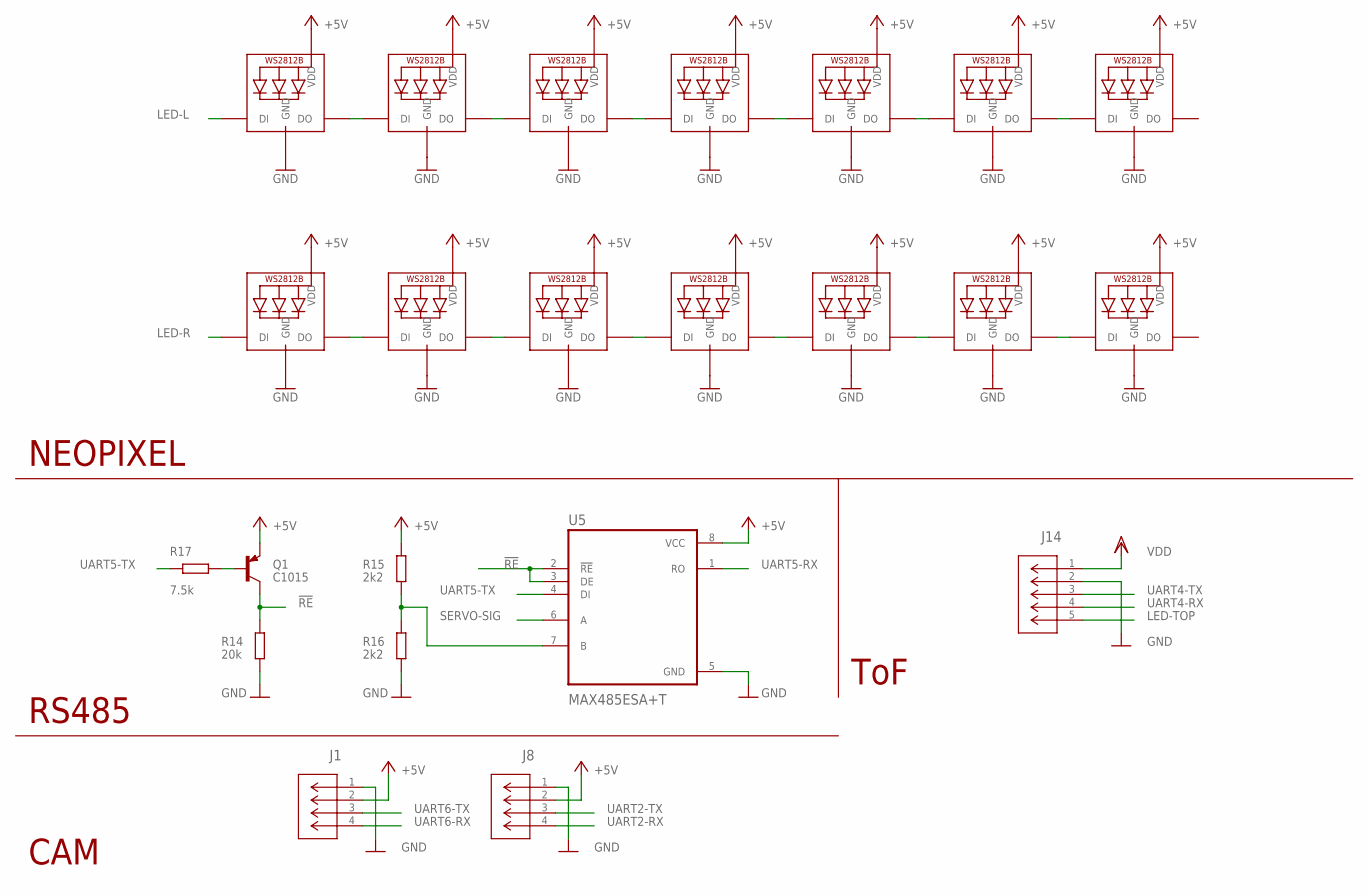
[picture p15: schematic 01-main.sch, sheet 2]

Parts:
J1, J8: 22057045; CON_22057045_MOL
J14: 22057055; CON_22057055_MOL
LED1, LED2, LED3, LED4, LED5, LED6, LED7, LED8, LED9, LED10, LED11, LED12, LED13, LED14: WS2812B_2020
Q1: C1015; SOT23
R14: 20k; R0402
R15, R16: 2k2; R0402
R17: 7.5k; R0402
U5: MAX485ESA+T; SOIC127P600X175-8N

Connections:
!RE: Q1.3 (C), R14.1, U5.2 (!RE), U5.3 (DE)
+5V: J1.2, J8.2, LED1.4 (VDD), LED2.4 (VDD), LED3.4 (VDD), LED4.4 (VDD), LED5.4 (VDD), LED6.4 (VDD), LED7.4 (VDD), LED8.4 (VDD), LED9.4 (VDD), LED10.4 (VDD), LED11.4 (VDD), LED12.4 (VDD), LED13.4 (VDD), LED14.4 (VDD), Q1.2 (E), R15.1, U5.8 (VCC); also elsewhere on the board
GND: J1.1, J8.1, J14.2, LED1.2 (GND), LED2.2 (GND), LED3.2 (GND), LED4.2 (GND), LED5.2 (GND), LED6.2 (GND), LED7.2 (GND), LED8.2 (GND), LED9.2 (GND), LED10.2 (GND), LED11.2 (GND), LED12.2 (GND), LED13.2 (GND), LED14.2 (GND), R14.2, R16.2, U5.5 (GND); also elsewhere on the board
LED-L: LED1.3 (DI); also elsewhere on the board
LED-R: LED8.3 (DI); also elsewhere on the board
LED-TOP: J14.5; also elsewhere on the board
unnamed: LED1.1 (DO), LED2.3 (DI)
unnamed: LED2.1 (DO), LED3.3 (DI)
unnamed: LED3.1 (DO), LED4.3 (DI)
unnamed: LED4.1 (DO), LED5.3 (DI)
unnamed: LED5.1 (DO), LED6.3 (DI)
unnamed: LED6.1 (DO), LED7.3 (DI)
unnamed: LED8.1 (DO), LED9.3 (DI)
unnamed: LED9.1 (DO), LED10.3 (DI)
unnamed: LED10.1 (DO), LED11.3 (DI)
unnamed: LED11.1 (DO), LED12.3 (DI)
unnamed: LED12.1 (DO), LED13.3 (DI)
unnamed: LED13.1 (DO), LED14.3 (DI)
unnamed: Q1.1 (B), R17.1
unnamed: R15.2, R16.1, U5.7 (B)
SERVO-SIG: U5.6 (A); also elsewhere on the board
UART2-RX: J8.4; also elsewhere on the board
UART2-TX: J8.3; also elsewhere on the board
UART4-RX: J14.4; also elsewhere on the board
UART4-TX: J14.3; also elsewhere on the board
UART5-RX: U5.1 (RO); also elsewhere on the board
UART5-TX: R17.2, U5.4 (DI); also elsewhere on the board
UART6-RX: J1.4; also elsewhere on the board
UART6-TX: J1.3; also elsewhere on the board
VDD: J14.1; also elsewhere on the board

Notes on the sheet:
NEOPIXEL
ToF
CAM
RS485
