TanoRoboRCJ/Hardware/PCB/01-main/01-main.brd

## EAGLE design PCB/01-main/01-main.brd (continued)

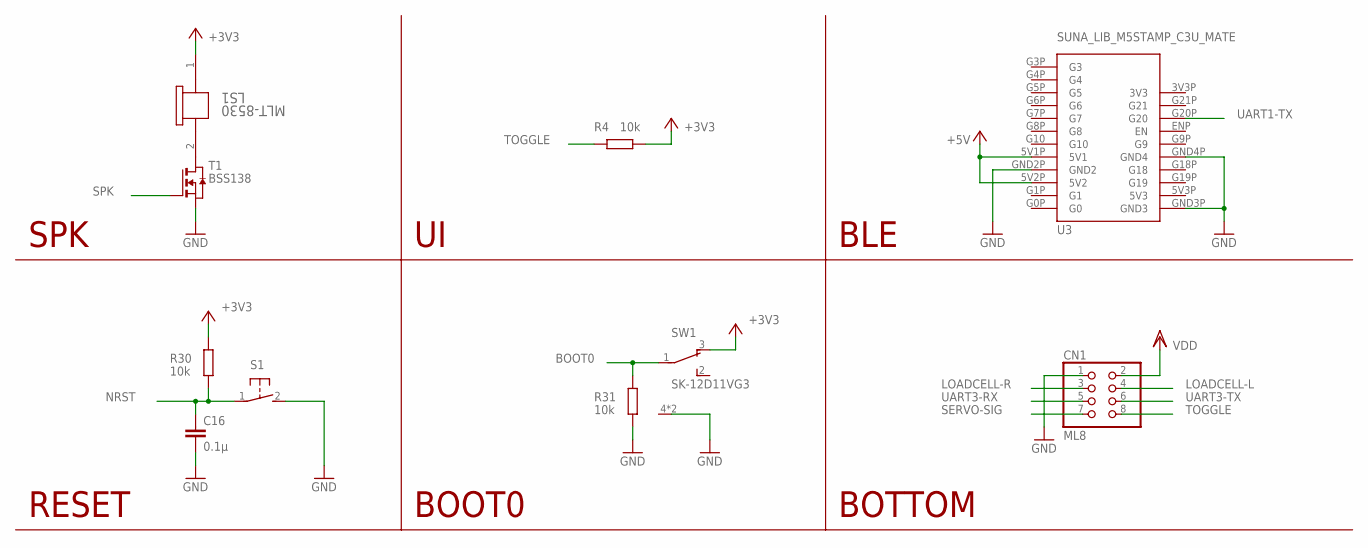
[picture p16: schematic 01-main.sch, sheet 3]

Parts:
C16: 0.1µ; C0603
CN1: ML8; ML6L
LS1: MLT-8530; MLT-8530_JHE
R4, R30, R31: 10k; R0402
S1: 31-XX; B3F-31XX
SW1: SK-12D11VG3
T1: BSS138; SOT-23
U3: SUNA_LIB_M5STAMP_C3U_MATE; SUNA_LIB_M5STAMPC3UMATE

Connections:
+3V3: LS1.1, R4.1, R30.1, SW1.3 (O); also elsewhere on the board
+5V: U3.5V1P (5V1), U3.5V2P (5V2); also elsewhere on the board
BOOT0: R31.1, SW1.1; also elsewhere on the board
GND: C16.2, CN1.1, R31.2, S1.2 (S), SW1.4 (CASE), SW1.5 (CASE), T1.2 (S), U3.GND2P (GND2), U3.GND3P (GND3), U3.GND4P (GND4); also elsewhere on the board
LOADCELL-L: CN1.4; also elsewhere on the board
LOADCELL-R: CN1.3; also elsewhere on the board
unnamed: LS1.2, T1.1 (D)
NRST: C16.1, R30.2, S1.1; also elsewhere on the board
SERVO-SIG: CN1.7; also elsewhere on the board
SPK: T1.3 (G); also elsewhere on the board
TOGGLE: CN1.8, R4.2; also elsewhere on the board
UART1-TX: U3.G20P (G20); also elsewhere on the board
UART3-RX: CN1.5; also elsewhere on the board
UART3-TX: CN1.6; also elsewhere on the board
VDD: CN1.2; also elsewhere on the board

Notes on the sheet:
BOTTOM
SPK
RESET
BOOT0
BLE

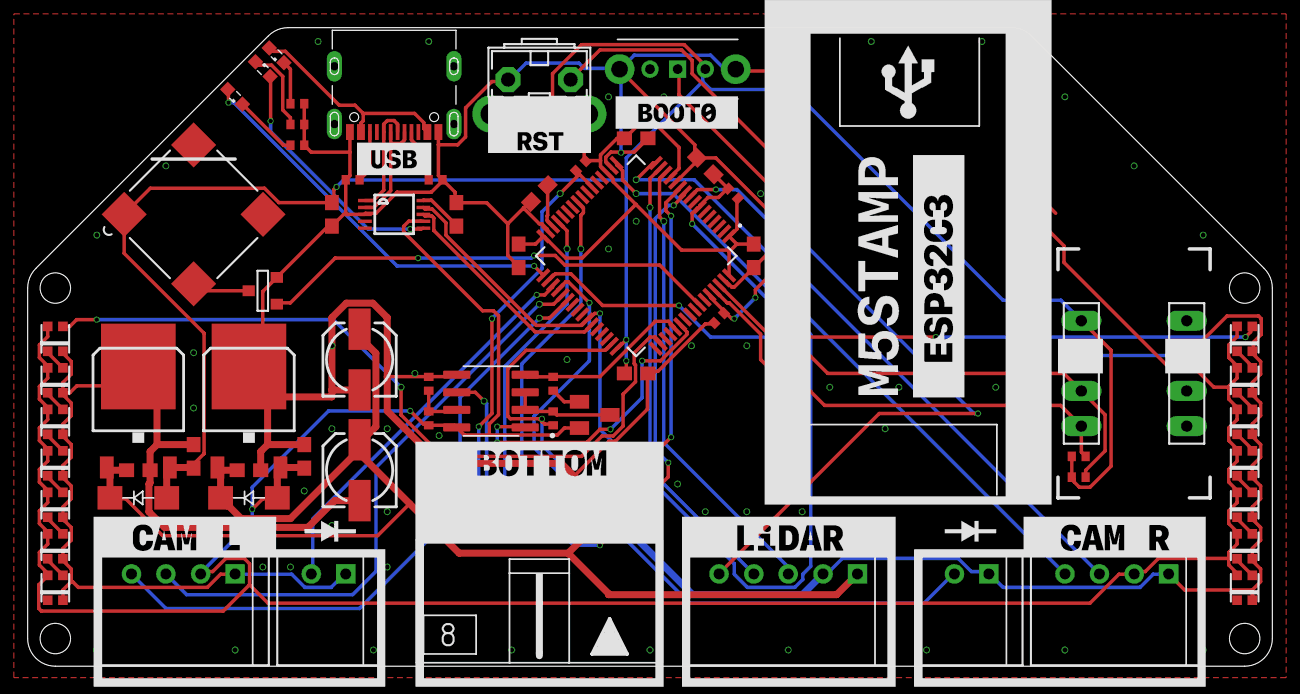
[picture p17: board 01-main.brd from above]

Board: 2 copper layers, 90.0 x 46.2 mm, 66 parts (0 on the bottom side), 58 nets.
