TanoRoboRCJ/Hardware/(commit log)

2024-01-16 ✨ ライセンス
2024-01-16 🎉 INUWASHI基板を移管
    [01-main.brd, 01-main.sch, 02-PWR.brd, 02-PWR.sch, 03-LiDAR.brd, 03-LiDAR.sch]
2024-01-18 ✏️ メイン基板部品配置完了
    [main-re.dxf]
2024-01-18 ⚡️基礎配線完了
    [01-main.brd, 01-main.sch]
2024-01-18 ✏️ i2Cのプルアップ抵抗の位置を変更
    [01-main.brd]
2024-01-18 ⚡️ ERC
    [01-main.brd, 01-main.sch]
2024-01-18 ⚡️ パスコンの位置を調整
    [01-main.brd]
2024-01-18 ✨ メイン配線
2024-01-18 ⚡️ 10milに改良
    [01-main.brd, 01-main.sch]
2024-01-18 ✨ ビアうち完了
    [01-main.brd]
2024-01-19 ✨ シルク完了
    [01-main.brd]
2024-01-20 ✨ 下段配線（ENC以外）完了
    [pwr-re.dxf]
2024-01-21 ✏️ Update README.md
2024-01-22 ✨エンコーダー配線完了
    [01-main.brd, 01-main.sch, 01-main_top_bom.csv, 02-PWR.brd, 02-PWR.sch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]
2024-01-23 ✨ 下段完成
    [02-PWR.brd, 02-PWR.sch]
2024-01-23 ✨ LIDAR
2024-01-23 ✏️ 一旦保存
    [03-LiDAR.brd, 03-LiDAR.sch]
2024-01-23 ✨ 基本配線完了
    [03-LiDAR.brd]
2024-01-23 ✨ とりあえずできた、一晩寝かせる
    [03-LiDAR.brd, 03-LiDAR.sch]
2024-01-25 ✨ LiDARのシルク入れ完了
    [03-LiDAR.brd]
2024-01-26 ♻️ 再配線中
    [02-PWR.brd, 02-PWR.sch]
2024-01-26 ♻️ ほぼ完成
    [02-PWR.brd]
2024-01-26 ✨ 完了
    [02-PWR.brd]
